judge2005/HVPS_SMD/README.md

# HVPS_SMD
A small, flexible nixie clock tube power supply. See the project description at [hackaday.io](https://hackaday.io/project/27899-nixie-tube-power-supply) for possibly more information than you thought you might ever need.
