judge2005/HVPS_SMD/HVPS_SMD_LTSpice/HVPSTransformerLM3478.asc

Cc: cap; 0.2µF
Ccomp: cap; 22nF; V=35 Rser=0.2
Cin: cap; 100µF; V=35 Rser=0.2
Cout: cap; .22µF; V=400 Rser=.25
Csen: cap; 0.01µF; V=35 Rser=0.2
Csnub: cap; {Csnub}
D1: diode; RFN10NS3S
M1: nmos; DMT6010LSS
PWM: voltage; PULSE(0 5 0 1n 1n 30u 62.5u)
R1: res; 1208k
R2: res; 10.2k
R3: res; 33k
Rc: res; 2k
Rcomp: res; 4.7k
Rfreq: res; 47k
Rload: res; 15k
Rsen: res; 0.06
Rsnub: res; {Rsnub}
U1: LM3478_TRANS
U2: FLEX_7491961_1_25
V1: voltage; 12; Rser=0.5
Named nets: 0, IN, OUT, Gate, Drain, Source, FB
.tran 0 40m 1u 1000n uic
.param AG=25013 PR=1 PL=1 SR=5 SL=5
.include LM3478_TRANS.LIB
.include irli2910.spi
This is about right. High values (say 220nF) produce
a longer ramp-up and tend to produce overshoot on
the ramp up and a subsequentover-drop as it compensates.
Lower values are OK but tend to produce a small 'ringing' effect.
This is not very sensitive. The original value of 4.7k is fine.
2xCoss
SQRT(Lp/Cp) or 1/(Csnub * 2pi *Fring)
Lp = Parasitic Inductance
Cp = Parasitic Capacitance
1uF is fine. More just
stretches the ramp up out.
This seems optimum
In real life, this overheating causes the output
to drop significantly. This happens as load increases
and is a factor of Rdson. Originally used a FET with
Rdson of around 100m. Now use 30m. Also, for SM
FETs, need to ensure that Vd does not exceed about
30V
.include DMT6010LSS.txt
.param Rsnub=1/({Csnub}*2*3.1415927*5000000)
.param Csnub=2000pF
Off-board PWM + RC filter voltage source.
