judge2005/HVPS_SMD/HVPS_SMD/HVPS_SMD.kicad_pcb

## KiCad design HVPS_SMD/HVPS_SMD.kicad_pcb (2017-11-28)

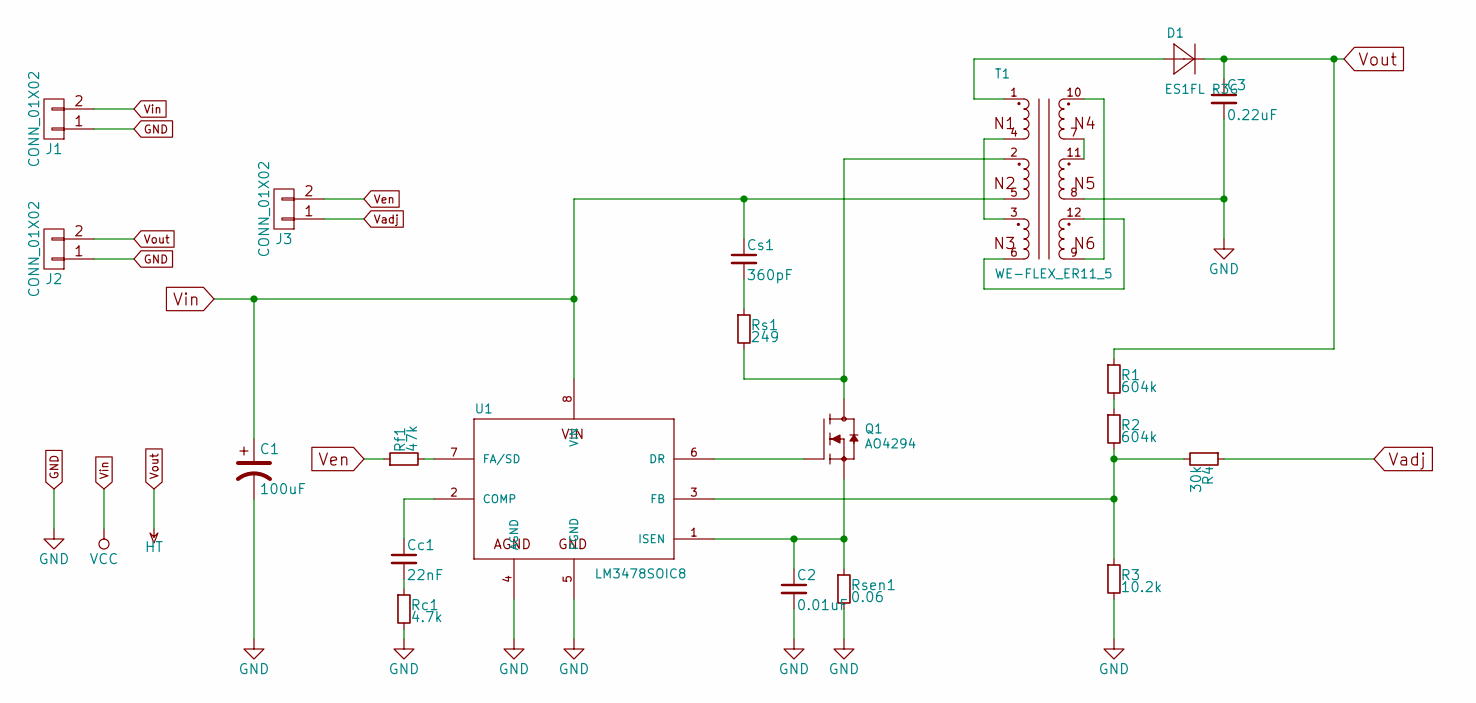
[picture p1: schematic HVPS_SMD.sch]

Parts:
C1: 100uF; C_1210
C2: 0.01uF; C_0603
C3: 0.22uF; C_1210
Cc1: 22nF; C_0603
Cs1: 360pF; C_0603
D1: ES1FL R3G; nixiemisc-DO-219AB
J1, J2, J3: CONN_01X02; SparkFun-Connectors-1X02_NO_SILK
Q1: AO4294; nixiemisc-SO08
R1, R2: 604k; R_0805
R3: 10.2k; R_0603
R4: 30k; R_0603
Rc1: 4.7k; R_0805
Rf1: 47k; R_0805
Rs1: 249; R_1206
Rsen1: 0.06; R_2010
T1: WE-FLEX_ER11_5; nixiemisc-WE-FLEX_ER11_5
U1: LM3478SOIC8; nixiemisc-SOIC8

Connections:
GND: C1.2, C2.2, C3.2, J1.1, J2.1, R3.2, Rc1.2, Rsen1.2, T1.8 (5), U1.4 (AGND), U1.5 (PGND)
unnamed: C2.1, Q1.1 (S), Q1.2 (S), Q1.3 (S), Rsen1.1, U1.1 (ISEN)
unnamed: Cc1.1, U1.2 (COMP)
unnamed: Cc1.2, Rc1.1
unnamed: Cs1.2, Rs1.1
unnamed: D1.A, T1.1
unnamed: Q1.4 (G), U1.6 (DR)
unnamed: Q1.5 (D), Q1.6 (D), Q1.7 (D), Q1.8 (D), Rs1.2, T1.2 (11)
unnamed: R1.2, R2.1
unnamed: R2.2, R3.1, R4.2, U1.3 (FB)
unnamed: Rf1.2, U1.7 (FA/SD)
unnamed: T1.3 (9), T1.4 (12)
unnamed: T1.9 (7), T1.10 (2)
unnamed: T1.7 (3), T1.11 (4)
unnamed: T1.6 (8), T1.12 (6)
Vadj: J3.1, R4.1
Ven: J3.2, Rf1.1
Vin: C1.1, Cs1.1, J1.2, T1.5 (10), U1.8 (VIN)
Vout: C3.1, D1.C, J2.2, R1.1

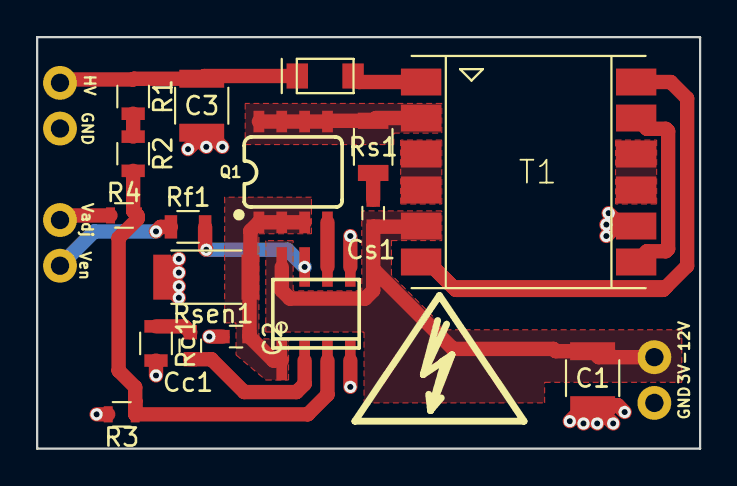
[picture p2: board HVPS_SMD.kicad_pcb from above]

Board: 2 copper layers, 36.8 x 22.9 mm, 20 parts (0 on the bottom side), 19 nets.
